jonardan/OpenSCARA/hardware/stl/Braccio_LatoAnteriore.stl

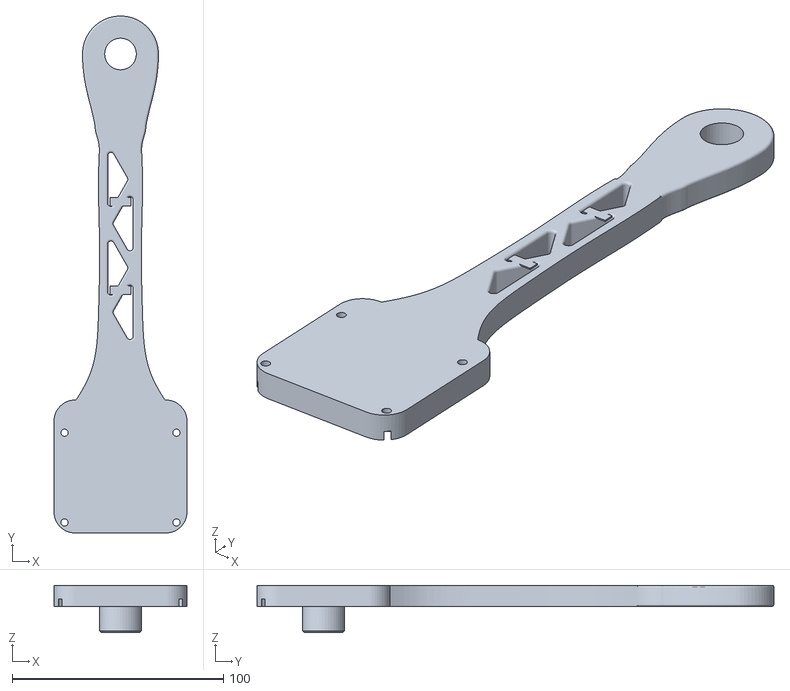
[picture p2: CAD file, 2026-10-12]
hardware/stl/Braccio_LatoAnteriore.stl
63.0 x 244.9 x 22.5
