jonardan/OpenSCARA/hardware/stl/Gomito_DadoM14.stl

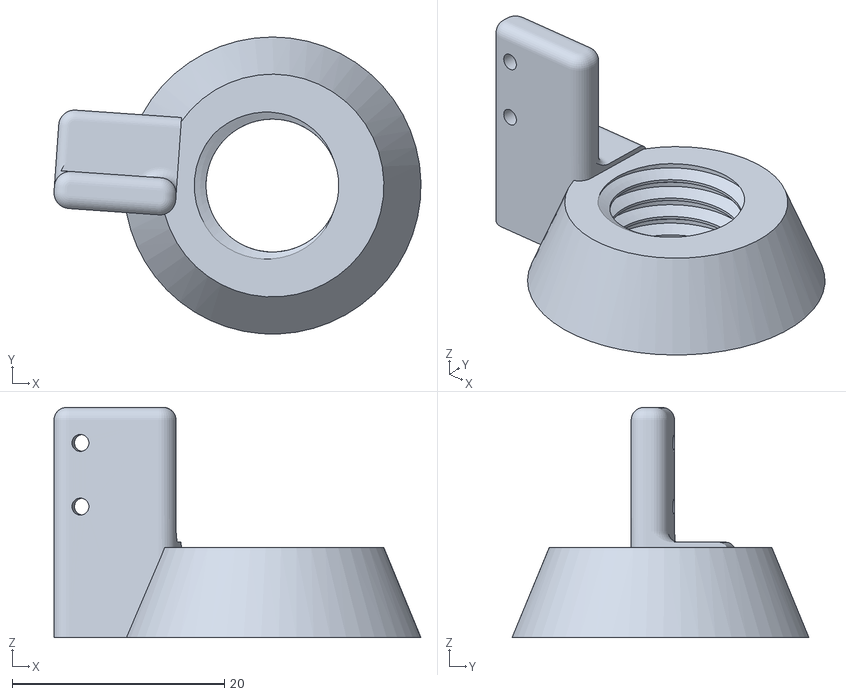
[picture p3: CAD file, 2026-10-12]
hardware/stl/Gomito_DadoM14.stl
34.6 x 28.0 x 21.7
