jonardan/OpenSCARA/hardware/stl/Spalla_Puleggia72T.stl

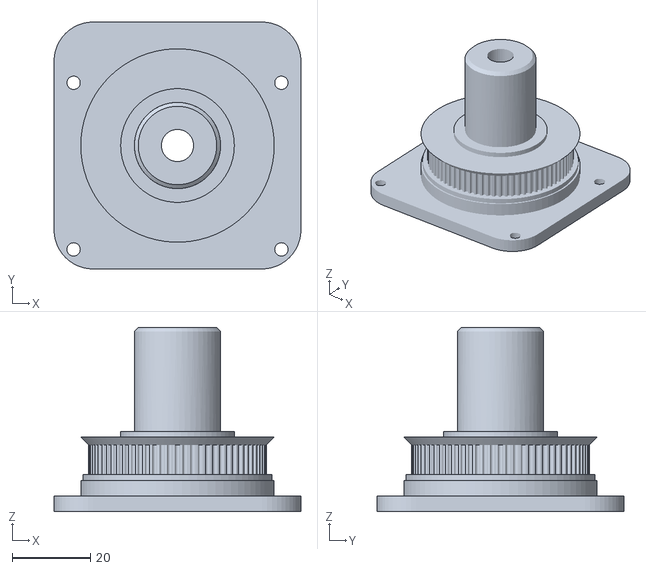
[picture p4: CAD file, 2026-10-12]
hardware/stl/Spalla_Puleggia72T.stl
63.0 x 63.0 x 47.0
