jonardan/OpenSCARA/hardware/stl/Base_SupportoPosteriore.stl

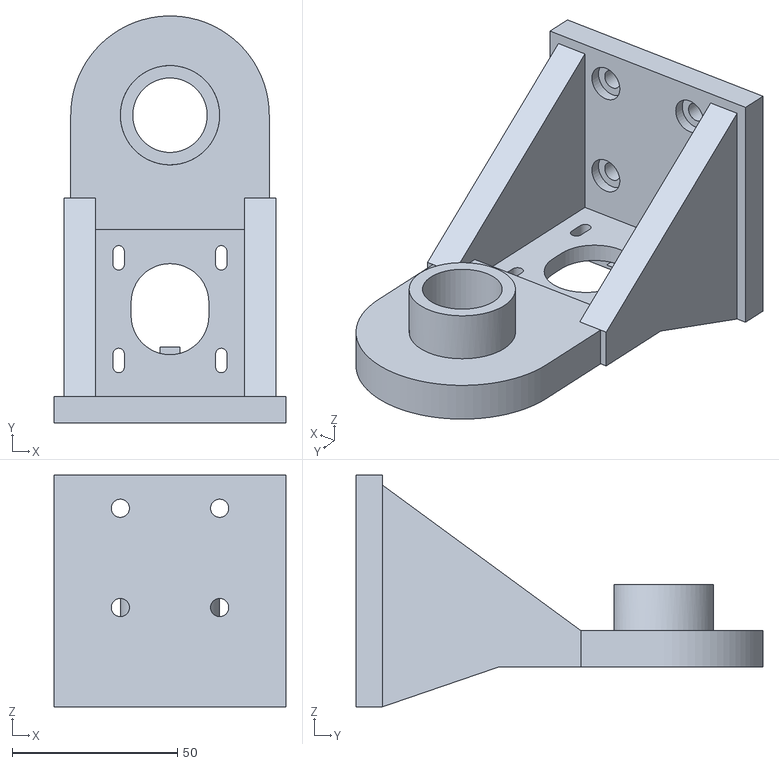
[picture p5: CAD file, 2026-10-12]
hardware/stl/Base_SupportoPosteriore.stl
70.0 x 123.0 x 70.0
