jonardan/OpenSCARA/hardware/stl/Braccio_LatoMotore.stl

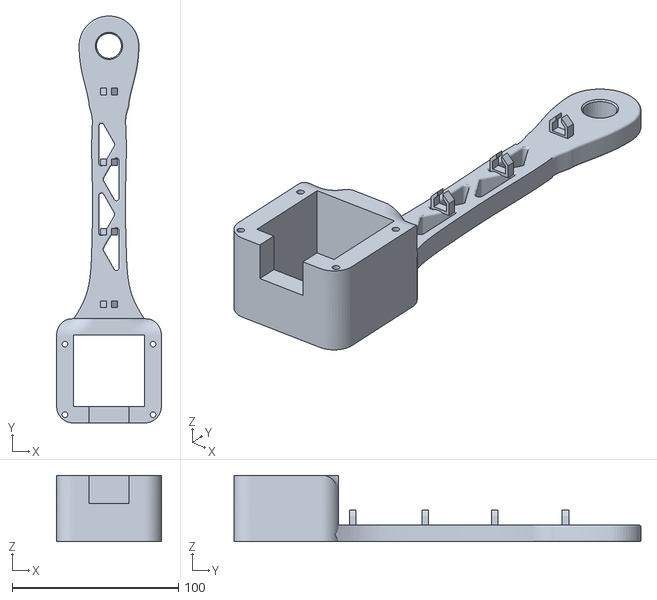
[picture p6: CAD file, 2026-10-12]
hardware/stl/Braccio_LatoMotore.stl
63.0 x 244.9 x 40.0
