jonardan/OpenSCARA/(list of files, cad)

Other CAD files:
hardware/fusion/robot_claude.f3d
