jonardan/OpenSCARA/(commit log)

2026-10-11 Import BBB + TMC2209 Buildroot files as a BR2_EXTERNAL tree
    Move the tmc2209ctl package, BeagleBone board files (DTS, boot config,
    genimage, USB console) and defconfig out of the Buildroot source tree
    into this repo, and add the SuperMatt agent setup: local-markdown issue
    tracker, default triage labels, single-context domain docs.
2026-10-11 Split repo into software/ and hardware/
    Buildroot BR2_EXTERNAL tree moves to software/; hardware/stl and
    hardware/fusion hold the printable parts and Fusion sources.
2026-10-11 Document wiring in software/README.md
    Pin tables, ASCII and Mermaid diagrams for both TMC2209 drivers, motors,
    power, grounds and the planned endstops on P9_14/P9_22.
2026-10-11 Add motion control plan: endstops to G-code
2026-10-11 Plan: motor 2 rides on link 1, home elbow first
    No belt coupling step needed; steps renumbered 1-10.
2026-10-11 Plan: arm lengths and pulley ratios
2026-10-11 Plan: measure home angles and joint limits on the arm in step 4
2026-10-11 Mux endstop pins P9_14 and P9_22 as inputs with pull-up
    Plan step 1. Also adds the libgpiod2 tools to the image so the
    switches can be checked with gpioget, and drops "planned" from the
    endstop docs.
2026-10-11 tmc2209ctl: endstop command reads the switches
    endstop prints each motor's switch (endstop_line, honouring endstop_nc)
    as released or pressed; endstop watch prints every change, debounced,
    until Ctrl-C.
2026-10-11 tmc2209ctl: home command drives each joint onto its switch
    Turns toward the switch (home_dir) at home_rpm, backs off 5 degrees,
    comes back at home_rpm / 5 and stops on the click; gives up after one
    joint revolution. Motor 2 (elbow) homes before motor 1. The position
    and a homed flag go to /run/scara.pos; disable, run, init and
    microsteps clear homed.
2026-10-11 Step 4: joint angles with the new scara program
    Move the driver code (config, UART, position file, STEP/DIR moves,
    endstops, homing) out of tmc2209ctl.c into tmc2209.c/tmc2209.h with no
    behaviour change, so a second program can share it.
    New "scara" program: home, where (joint angles), joint A1 A2 (absolute,
    synchronised, needs homing, inside min_angle..max_angle) and jog J DEG
    (relative, ignores limits, for measuring). home_angle and the joint
    limits measured on the arm go in tmc2209.conf; the procedure is in the
    board readme. GLOSSARY.md records the angle conventions.
2026-10-11 Step 5: kinematics, joint angles <-> tip X/Y
    kinematics.c: forward and inverse kinematics of the two-link arm, with
    the elbow side choice (+/-, or whichever fits the joint limits, the one
    closer to the current pose) and errors for points too far, too close or
    only reachable outside the limits. No hardware code: make test runs
    test_kinematics on the PC (IK(FK) over the whole joint range, known and
    unreachable points).
    scara gains fk A1 A2 and ik X Y [+|-], which only compute, and where
    prints the tip X/Y once homed. link1_mm / link2_mm go in tmc2209.conf.
2026-10-11 Step 6: scara goto, move the tip to X/Y
    goto X Y [+|-] [RPM] runs the inverse kinematics, then the same
    synchronised joint move as 'joint' (shared as move_to_angles: needs
    homing, refuses angles outside the limits). The board readme gains the
    100 mm square check: sides and diagonals need no origin on the paper, and
    what a wrong link length or home_angle looks like.
2026-10-11 Step 7: scara line, straight lines at constant tip speed
    line X Y [F] moves the tip to X/Y in a straight line at F mm/s
    (default line_speed, accel line_accel in tmc2209.conf). line.c splits the
    line into 1 mm segments with IK at every point, elbow kept on its side,
    and refuses lines leaving the reach or the limits or passing too close to
    the shoulder (host-tested in test_line). move_path in tmc2209.c streams
    the segments through one stepping loop that accelerates only at the ends
    and slows the whole line if a motor would exceed its rpm. The motor setup
    of move_axes is shared with it (axis_prepare/axis_lines). The board readme
    gains the straight-edged square and a stopwatch speed check.
2026-10-11 Step 9: G-code parser and scara gcode
    gcode.c parses one G-code line, without moving anything: G0, G1 (F in
    mm/min, modal), G28, G90/G91, G21, M3/M5 (M106/M107), M2/M30, comments
    ; and ( ), N line numbers, % and *nn checksums; unknown codes, G20 and
    repeated words are errors. Host-tested in test_gcode with sample lines
    and square.gcode, which is also installed as /usr/share/scara/square.gcode.
    scara gcode [-n] FILE (- for stdin) checks the whole file first, syntax
    then every move planned from the previous one, and reports the first bad
    line without moving; then it runs G0 as goto, G1 as line, G28 as home.
    goto and line are split out of their commands (goto_xy, line_to) for it.
    The tip LED i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
2026-10-11 Step 10: scara gcode - streams stdin, answering ok per line
    scara gcode - no longer reads all of stdin first: each line is parsed,
    checked on paper from where the arm is (reach and joint limits), run,
    then answered "ok" and flushed, so a PC-side sender that waits for the
    answer before the next line can feed a drawing over the console. A bad
    line or Ctrl-C answers "error" and stops; M2 or Ctrl-D ends it. The
    per-line logic of the file runner moved into run_line, shared by both.
    The FILE form is unchanged (whole file checked first).
    circle.gcode (50 mm radius, 72 G1 segments) is installed next to
    square.gcode as the circle test. LED parts wait for step 8.
2026-10-11 spiral.gcode replaces circle.gcode as the curve test
    A 5-turn spiral around X200 Y0, 5 to 80 mm radius, 360 G1 segments every
    5 degrees: with the look-ahead it runs as one path.
2026-10-11 Issue tracker: motor 2 STEP/DIR, square check after belts, tip LED (step 8 patch)
2026-10-11 Drawing guide: SVG to G-code and copy over the USB console
    tools/svg2gcode.py turns an SVG (Inkscape, Hershey Text) into G0/G1/M3/M5
    G-code, scaled and centred on the workspace (default 150 mm at X200 Y0).
    tools/bbb_send.py copies a file to the board over /dev/ttyACM0 as a
    here-document, checked with md5sum. docs/drawing.md explains both, the
    other ways to copy (SD card, Ethernet + wget) and proposes dropbear over
    USB ethernet.
2026-10-12 line_accel 400 as on the board; example drawings: shapes at F9000, paper plane
2026-10-12 README: overview and homing GIFs
2026-10-12 README: swap the GIFs, the longer video is the homing one
2026-10-12 hardware: STL of every printed part and the Fusion design (robot claude v41)
2026-10-12 docs: rewrite the READMEs, move the command reference to docs/commands.md
    The top README now follows a highlights / overview / usage / installation
    / links / feedback shape with emoji headers and names the author. The full
    scara, tmc2209ctl, settings and SVG tool reference moved unchanged to
    docs/commands.md. hardware/ and software/ READMEs get an intro and
    navigation; the wiring guide keeps all its pin and wiring detail.
